HandHeldLegend/Open-GC-Ultimate/HW/Production/Trigger/UGC_Trigger.csv

# | Reference | Qty | MPN | Description | Value | Footprint | LCSC | Link | DNP
1 | RV1 | 1 | RD7091008A | Position sensor - PACK INDIVIDUALLY | Slider_GCC-Gamecube_SolderInsert | hhl:GCC_Slider_MillMaxSocketed | C127475 |  | DNP
