HandHeldLegend/Open-GC-Ultimate/HW/Production/MechTrigger/UGC_MechTrigger.csv

Reference | Value | Footprint | Qty | DNP | MPN | Price
SW1 | SW_Push | hhl:PG1353 | 1 |  | CPG135301D03 | 0.45
