HandHeldLegend/Open-GC-Ultimate/HW/Production/CablePlug.stl

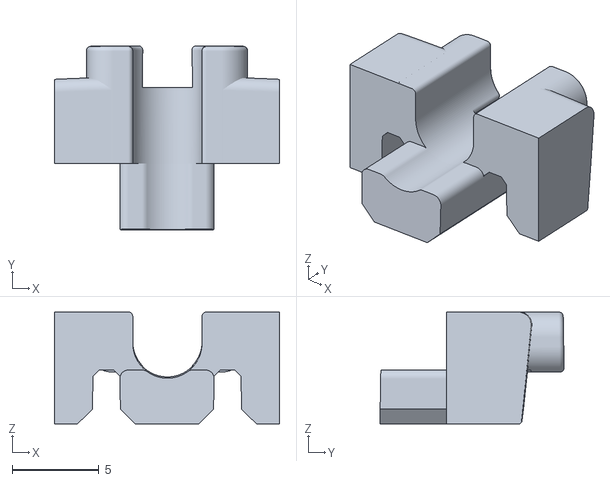
[picture p1: CAD file, 2024-10-29]
HW/Production/CablePlug.stl
13.0 x 10.6 x 6.47
