HandHeldLegend/Open-GC-Ultimate/HW/SubStick/UGC_SubStick.kicad_pcb

## KiCad design HW/SubStick/UGC_SubStick.kicad_pcb (2024-10-29)

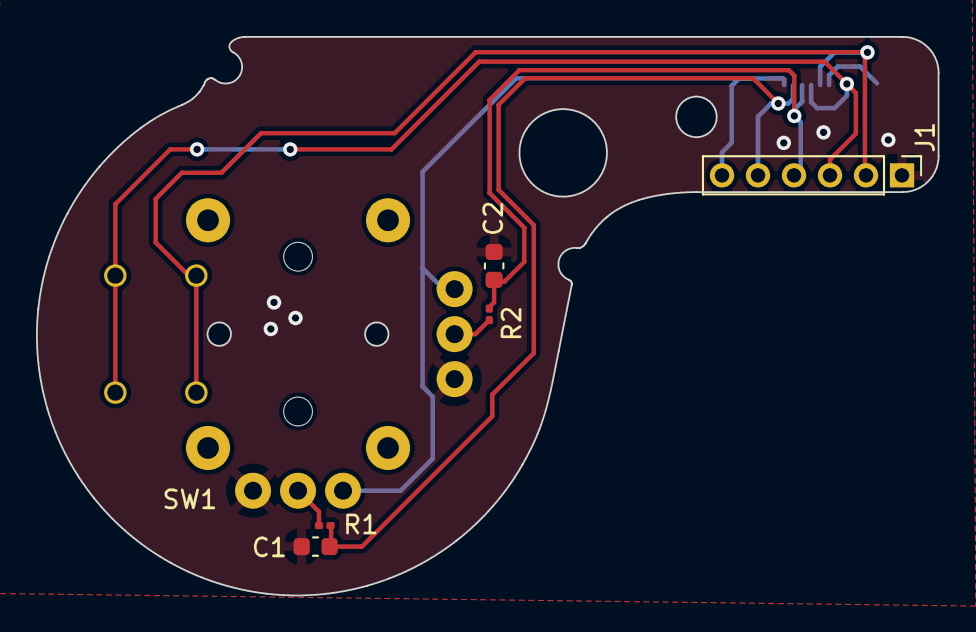
[picture p2: board UGC_SubStick.kicad_pcb from above]

Board: 2 copper layers, 50.1 x 31.0 mm, 7 parts (1 on the bottom side), 8 nets.

Parts:
C1, C2: 47nF; C_0603_1608Metric
J1: Conn_01x06_Pin; PinHeader_1x06_P2.00mm_Vertical
J2: 503480-0640; 5034800640
R1, R2: 1k; R_0201_0603Metric
SW1: GL18_SW; GL1807SYAE

Connections:
+3V3: J1.6, J2.6, SW1.X3 (VCC), SW1.Y3 (VCC)
GND: C1.1, C2.1, J1.1, J2.1, J2.MP1, J2.MP2, SW1.X1 (GND), SW1.Y1 (GND)
unnamed: R1.1, SW1.X2 (X_OUT)
unnamed: R2.1, SW1.Y2 (Y_OUT)
RS_B_IN: J1.3, J2.3, SW1.S3 (3), SW1.S4 (4)
RS_B_OUT: J1.2, J2.2, SW1.S1 (1), SW1.S2 (2)
RX: C1.2, J1.5, J2.5, R1.2
RY: C2.2, J1.4, J2.4, R2.2
