HandHeldLegend/Open-GC-Ultimate/HW/Trigger/UGC_Trigger.kicad_pcb

## KiCad design HW/Trigger/UGC_Trigger.kicad_pcb (2024-10-29)

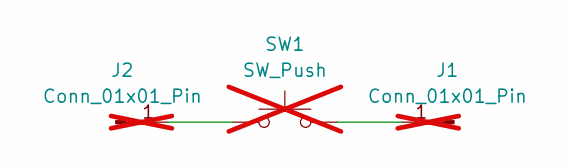
[picture p5: schematic UGC_Trigger.kicad_sch]

Parts:
J1, J2: Conn_01x01_Pin; PinHeader_1x01_P2.00mm_Vertical; not fitted
SW1: SW_Push; starprint; not fitted

Connections:
unnamed: J1.1, SW1.2
unnamed: J2.1, SW1.1

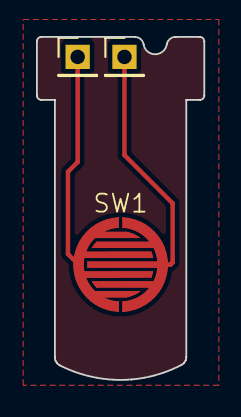
[picture p6: board UGC_Trigger.kicad_pcb from above]

Board: 2 copper layers, 9.3 x 19.1 mm, 3 parts (0 on the bottom side), 2 nets.
