HandHeldLegend/Open-GC-Ultimate/HW/Main/UGC_OpenMain.kicad_pcb

## KiCad design HW/Main/UGC_OpenMain.kicad_pcb (2024-10-29)

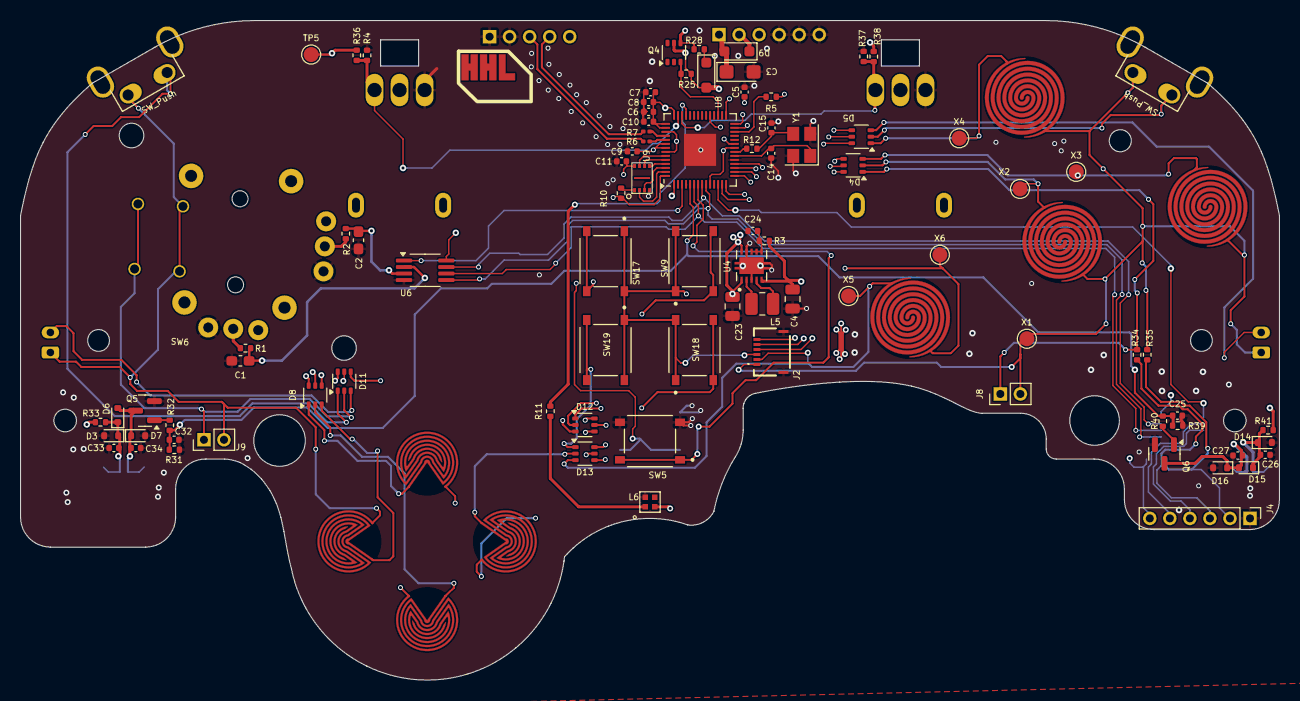
[picture p7: board UGC_OpenMain.kicad_pcb from above]

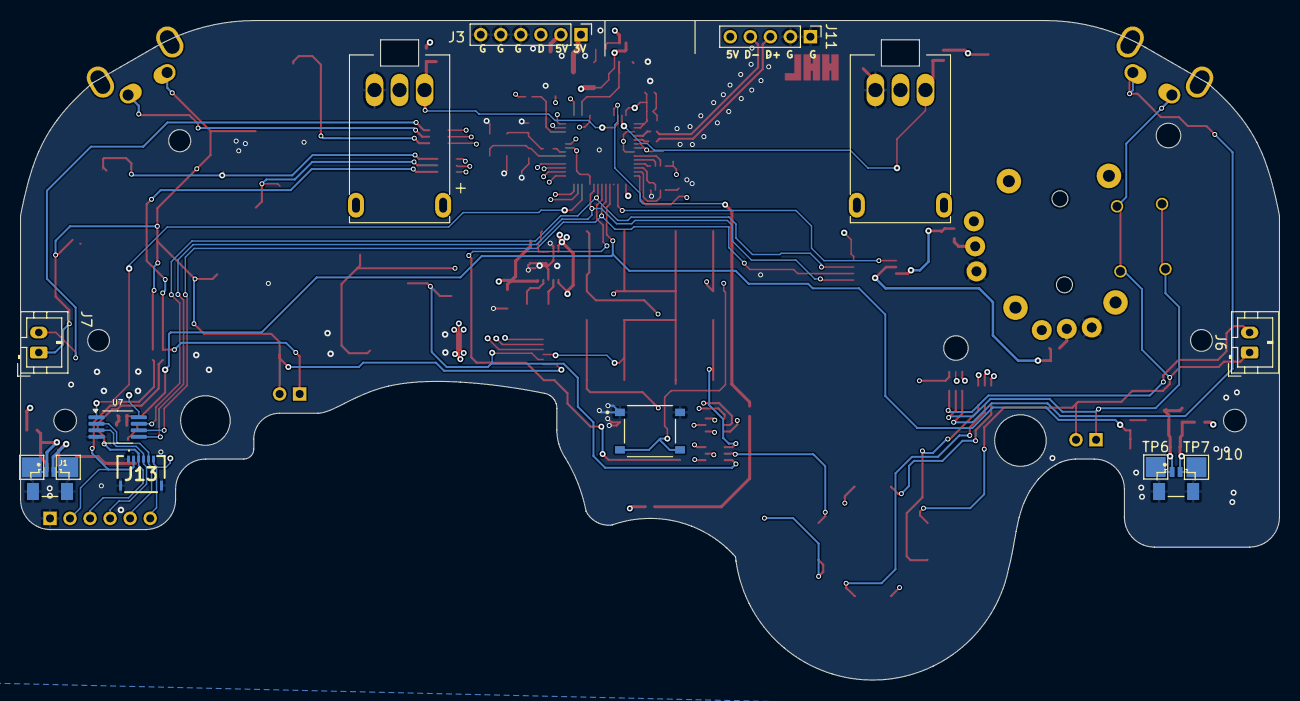
[picture p8: board UGC_OpenMain.kicad_pcb from below]

Board: 4 copper layers, 125.7 x 65.8 mm, 116 parts (21 on the bottom side), 78 nets.

Parts:
C1, C2: 47nF; C_0603_1608Metric_Pad1.08x0.95mm_HandSolder
C3: 47uF; CP_EIA-3216-18_Kemet-A
C4, C23: 10uF; C_0805_2012Metric
C5, C6, C7, C9, C10, C11, C24, C25, C32: 100nF; C_0402_1005Metric
C8, C26, C27, C33, C34: 1uF; C_0402_1005Metric
C14, C15: 15pF; C_0402_1005Metric
D3, D6, D7, D14, D15, D16: M7C; D_SOD-523
D4, D5, D8, D11, D12, D13: BAS16VY,115; SOT-363_SC-70-6
D9, D10: CUS08F30; D_SOD-323_HandSoldering
J1, J10: SM02B-SURS-TF_LF__SN_; JST_SM02B-SURS-TF_LF__SN_
J2, J13: 503480-0640; 5034800640
J3, J4: Conn_01x06_Pin; PinHeader_1x06_P2.00mm_Vertical
J6, J7: Trigger; JST_PH_B2B-PH-K_1x02_P2.00mm_Vertical
J8, J9: Conn_01x02; PinHeader_1x02_P2.00mm_Vertical
J11: Conn_01x05_Pin; PinHeader_1x05_P2.00mm_Vertical
L5: 1.3A 2.2uH ±20% 80mΩ; L_1008_2520Metric
L6: SK6805-EC-15
Q4: BSS138DW; SOT-363_SC-70-6
Q5, Q6: MMBT2222A; SOT-23
R1, R2, R10, R12, R25, R28: 1k; R_0402_1005Metric
R3, R32, R40: 100R; R_0402_1005Metric
R4, R36, R37, R38: 75k; R_0402_1005Metric
R5, R31, R39: 10k; R_0402_1005Metric
R6, R7: 27R; R_0201_0603Metric
R11: 330R; R_0402_1005Metric
R33, R34, R35, R41: 0R; R_0402_1005Metric
RV1, RV2: Slider_GCC-Gamecube_MB; GCC_Slider_MillMaxSocketed
S1, S2, S3, S4, S5, S6: 4015-0-43-80-30-27-10-0
SW1, SW2, SW3, SW4: SW_Push; ring_pad
SW5, SW9, SW14, SW17, SW18, SW19: SW_TS-1187A; TS-1187A-C-E-B
SW6: GL18_SW; GL1807SYAE
SW7, SW8: SW_Push; Z_Switch_Edge_Omron
SW10, SW11, SW12, SW13: SW_Push; ring_dpad
TP1, TP2, TP6, TP7: TestPoint; TestPoint_Pad_2.0x2.0mm
TP5: TestPoint; TestPoint_Pad_D1.5mm
U4: TPS630001RCR; VREG_V62_16624-01YE
U6, U7: MCP3002; MSOP-8_3x3mm_P0.65mm
U8: RP2040; QFN-56-1EP_7x7mm_P0.4mm_EP3.2x3.2mm
U9: GD25Q80EEIGR; USON-8-EP(2x3)
X1, X2, X3, X4, X5, X6: ModConnect; TestPoint_Pad_D1.5mm
Y1: ABM8-272-T3; Crystal_SMD_3225-4Pin_3.2x2.5mm

Connections:
+1V1: C5.2, U8.23 (DVDD), U8.45 (VREG_VOUT), U8.50 (DVDD)
+3V3: C6.1, C7.1, C8.1, C9.2, C10.2, C11.1, C23.1, D10.2 (A), J4.6, J13.6, L6.2 (VDD), Q4.5 (G2), R5.1, R25.1, R33.2, R36.2, R38.2, R41.2, S1.1, S4.1, SW6.X3 (VCC), SW6.Y3 (VCC), TP5.1, U4.1 (VOUT), U4.10 (FB), U6.8 (VDD/VREF), U7.8 (VDD/VREF), U8.1 (IOVDD), U8.10 (IOVDD), U8.22 (IOVDD), U8.33 (IOVDD), U8.42 (IOVDD), U8.43 (ADC_AVDD), U8.44 (VREG_IN), U8.48 (USB_VDD), U8.49 (IOVDD), U9.8 (VCC)
+3V3_PRE: C3.1, D9.2 (A), J3.1
A: D4.6 (K), D8.6 (K), D12.6 (K), U8.29 (GPIO18)
B: D4.5 (K), D8.5 (K), D12.5 (K), U8.28 (GPIO17)
BTN_PWR: SW5.A, SW5.B, U8.7 (GPIO5)
C: D4.4 (K), D8.4 (K), D12.4 (K), U8.27 (GPIO16)
D: D5.6 (K), D11.6 (K), D13.6 (K), U8.18 (GPIO15)
D+: J11.3, R6.1
D-: J11.4, R7.1
E: D5.5 (K), D11.5 (K), D13.5 (K), U8.17 (GPIO14)
F: D5.4 (K), D11.4 (K), D13.4 (K), U8.16 (GPIO13)
G: J2.1, J7.1, J8.2, R35.2, SW1.1, SW3.1, SW4.1, SW8.1, U8.15 (GPIO12), X1.1
GND: C1.1, C2.1, C3.2, C4.1, C5.1, C6.2, C7.2, C8.2, C9.1, C10.1, C11.2, C14.2, C15.2, C23.2, C24.1, C25.2, C26.1, C27.2, C32.2, C33.1, C34.2, D3.2 (A), D7.2 (A), D14.2 (A), D16.2 (A), J1.S1 (SHIELD), J1.S2 (SHIELD), J2.MP1, J2.MP2, J3.4, J3.5, J3.6, J4.1, J10.S1 (SHIELD), J10.S2 (SHIELD), J11.1, J11.2, J13.1, J13.MP1, J13.MP2, L6.4 (GND), Q5.2 (E), Q6.2 (E), R4.1, R31.1, R37.1, R39.1, S3.1, S6.1, SW5.C, SW5.D, SW6.X1 (GND), SW6.Y1 (GND), SW14.A, SW14.B, U4.3 (PGND), U4.9 (GND), U4.11 (EP), U6.4 (VSS), U7.4 (VSS), U8.19 (TESTEN), U8.57 (GND), U9.4 (VSS), Y1.2, Y1.4
H: J6.1, J9.2, SW6.S1 (1), SW6.S2 (2), SW7.1, SW10.1, SW11.1, SW12.1, U8.14 (GPIO11)
I: J2.3, SW2.1, SW9.A, SW9.B, SW13.1, SW17.A, SW17.B, SW18.A, SW18.B, SW19.A, SW19.B, U8.13 (GPIO10), X6.1
LADC_CS: U6.1 (~CS/SHDN), U8.3 (GPIO1)
LRA_L+: C33.2, D3.1 (K), D6.1 (K), J10.2, R33.1, TP7.1
LRA_L-: C34.1, D6.2 (A), D7.1 (K), J10.1, Q5.3 (C), TP6.1
LRA_R+: C26.2, D14.1 (K), D15.1 (K), J1.1, R41.1, TP2.1
LRA_R-: C27.1, D15.2 (A), D16.1 (K), J1.2, Q6.3 (C), TP1.1
LS_BTN_IN: D11.2 (A), J9.1, SW6.S3 (3), SW6.S4 (4)
LX: C1.2, R1.2, U6.2 (CH0)
LY: C2.2, R2.2, U6.3 (CH1)
N_DATA: J3.3, Q4.4 (S2), R28.2
N_DATA_3.3: Q4.3 (D2), R25.2, U8.31 (GPIO20)
unnamed: C15.1, R12.2, Y1.3
unnamed: D4.1 (A), J8.1, R34.1
unnamed: D5.2 (A), SW8.2
unnamed: D5.3 (A), J7.2
unnamed: D8.1 (A), SW10.2
unnamed: D8.2 (A), SW11.2
unnamed: D8.3 (A), SW12.2
unnamed: D11.1 (A), SW7.2
unnamed: D11.3 (A), J6.2
unnamed: D12.1 (A), SW9.C, SW9.D
unnamed: D12.2 (A), SW17.C, SW17.D
unnamed: D12.3 (A), SW18.C, SW18.D
unnamed: D13.1 (A), SW19.C, SW19.D
unnamed: D13.2 (A), SW13.2
unnamed: Q5.1 (B), R32.2
unnamed: Q6.1 (B), R40.2
unnamed: R1.1, SW6.X2 (X_OUT)
unnamed: R2.1, SW6.Y2 (Y_OUT)
unnamed: C24.2, R3.2, U4.6 (EN), U4.7 (PS/SYNC), U4.8 (VINA)
unnamed: L5.1, U4.4 (L1)
unnamed: L5.2, U4.2 (L2)
unnamed: R7.2, U8.46 (USB_DM)
unnamed: R6.2, U8.47 (USB_DP)
unnamed: R10.2, U9.1 (/CS)
RADC_CS: U7.1 (~CS/SHDN), U8.12 (GPIO9)
RGB_OUT: R11.2, U8.39 (GPIO27_ADC1)
RP_RUN: R5.2, U8.26 (RUN)
RS_B_IN: J4.2, J13.2, R35.1
RS_B_OUT: J4.3, J13.3, R34.2
RUMBLE_OUT: C25.1, C32.1, R31.2, R32.1, R39.2, R40.1, U8.5 (GPIO3)
RX: J4.5, J13.5, U7.2 (CH0)
RY: J4.4, J13.4, U7.3 (CH1)
SCLK: U8.52 (QSPI_SCLK), U9.6 (SCLK)
SHARED_PU: D10.1 (K), R28.1
SIO0: U8.53 (QSPI_SD0), U9.5 (IO0)
SIO1: U8.55 (QSPI_SD1), U9.2 (IO1)
SIO2: U8.54 (QSPI_SD2), U9.3 (IO2)
SIO3: U8.51 (QSPI_SD3), U9.7 (IO3)
SL_RGB: L6.1 (DIN), R11.1
SPI_CK: U6.7 (CLK), U7.7 (CLK), U8.8 (GPIO6)
SPI_RX: U6.6 (DOUT), U7.6 (DOUT), U8.6 (GPIO4)
SPI_TX: U6.5 (DIN), U7.5 (DIN), U8.9 (GPIO7)
USB_BOOT: R10.1, SW14.C, SW14.D, U8.56 (QSPI_SS)
VBUS_SYS: C4.2, D9.1 (K), J3.2, J11.5, R3.1, U4.5 (VIN)
X2: D4.2 (A), J2.4, SW1.2, X2.1
X3: D4.3 (A), J2.5, SW3.2, X3.1
X4: D5.1 (A), J2.6, SW4.2, X4.1
X5: D13.3 (A), J2.2, SW2.2, X5.1
XTAL_IN: C14.1, U8.20 (XIN), Y1.1
XTAL_OUT: R12.1, U8.21 (XOUT)
ZL_ANALOG: R4.2, R36.1, S2.1, U8.41 (GPIO29_ADC3)
ZR_ANALOG: R37.2, R38.1, S5.1, U8.40 (GPIO28_ADC2)
