HandHeldLegend/Open-GC-Ultimate/(commit log)

2024-10-29 Commit PCB Files
    [Open-GC-Ultimate-BOM.xlsx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]
2024-10-29 Add accessory boards
    [Open-GC-Ultimate-BOM.xlsx, UGC_MechTrigger.kicad_pcb, UGC_MechTrigger.kicad_sch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]
2024-10-29 Add cable plug
    [CablePlug.stl]
2024-10-29 Update all BOM etc.
    [BOM Open-GC-Ultimate.xlsx, BOM UGC SubStick.xlsx, Open-GC-Ultimate-BOM.xlsx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]
2024-10-29 Update accessories
    [BOM Open-GC-Ultimate.xlsx, UGC_OpenMain.csv, UGC_OpenMain.kicad_sch, UGC_Trigger.csv, UGC_Trigger.kicad_sch]
